opme/motor-driver/(list of files, drawings)

Other design files:
opm-inline-mcu/source/opm-inline.dsn
