opme/motor-driver/opm-inline/source/opm-inline.kicad_pcb

## KiCad design opm-inline/source/opm-inline.kicad_pcb (2022-01-27)

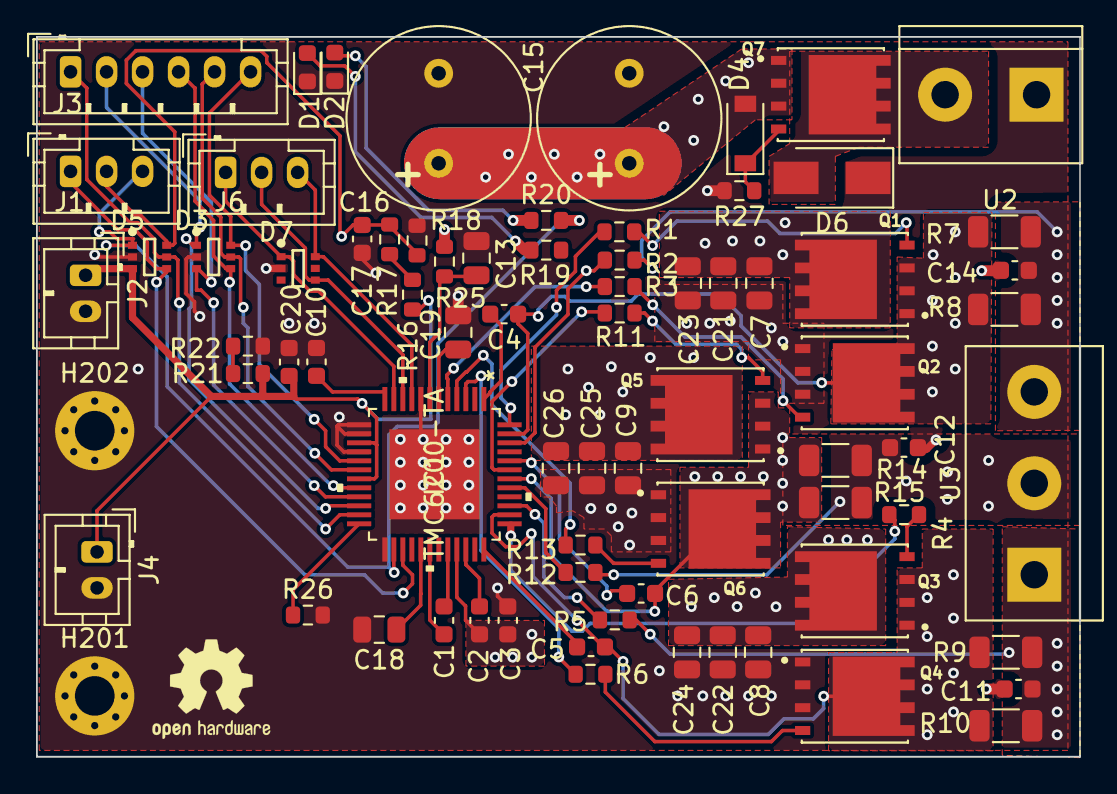
[picture p2: board opm-inline.kicad_pcb from above]

Board: 4 copper layers, 58.0 x 40.0 mm, 76 parts (0 on the bottom side), 53 nets.

Parts:
C1: 22nF/100V; C_0603_1608Metric
C2, C3: 100nF/100V; C_0603_1608Metric
C4: 4.7uF/16V; C_0603_1608Metric
C5, C6: 4.7UF/16V; C_0603_1608Metric
C7, C8, C9, C21, C22, C23, C24, C25, C26: 1uF/100V; C_0805_2012Metric
C10, C17, C20: 100nF/50V; C_0603_1608Metric
C11, C12, C14: 1nF/100V; C_0603_1608Metric
C13, C19: 2.2uF/50V; C_0805_2012Metric
C15, C16: 330uF/63V; C_Radial_D10.0mm_H20.0mm_P5.00mm
C18: 100nF/100V; C_0805_2012Metric
D1: Blue LED; LED_0603_1608Metric
D2: Red LED; LED_0603_1608Metric
D3, D5, D7: NUP4114UCW1T2G
D4: 10V; D_SOD-123
D6: TVS DIODE; D_SMA
H201, H202: MountingHole; MountingHole_2.2mm_M2_Pad_Via
HS1: Heatsink; OSHW-Logo2_7.3x6mm_SilkScreen
IC1: TMC6200-TA
J1: Info; JST_PH_B3B-PH-K_1x03_P2.00mm_Vertical
J2: VCC_IO; JST_PH_B2B-PH-K_1x02_P2.00mm_Vertical
J3: PWMx6; JST_PH_B6B-PH-K_1x06_P2.00mm_Vertical
J4: Fan; JST_PH_B2B-PH-K_1x02_P2.00mm_Vertical
J6: Current Sensing; JST_PH_B3B-PH-K_1x03_P2.00mm_Vertical
Q1, Q2, Q3, Q4, Q5, Q6: HYG025N06LS1C2; PDFN-8
Q7: WSD90P06DN56; PDFN-8
R1, R3, R4, R6, R11, R13: 2R2/1%; R_0603_1608Metric
R2, R5, R12: 10R/1%; R_0603_1608Metric
R7, R8, R9, R10, R14, R15: 0R005/1%/1W; R_1206_3216Metric
R16: 10000R/1%; R_0603_1608Metric
R17, R18: 4700R/1%; R_0603_1608Metric
R19: 2KR/1%; R_0603_1608Metric
R20: 200R/1%; R_0603_1608Metric
R21: 1000R/1%; R_0603_1608Metric
R22, R26: 0R; R_0603_1608Metric
R25: 0Ω; R_0603_1608Metric
R27: 100KR; R_0603_1608Metric
U2: TerminalBlock_2_P5.08mm; TerminalBlock_bornier-2_P5.08mm
U3: TerminalBlock_3_P5.08mm; TerminalBlock_bornier-3_P5.08mm

Connections:
/5Vout: C13.1, IC1.7 (5VOUT), R25.1
/12Vout: C19.1, IC1.6 (12VOUT)
/+VCC_IO: C20.1, D5.3 (K), IC1.15 (SDI/AMPLx10), IC1.19 (VCC_IO), J2.1, J4.1, R16.1, R21.1
/+VM: C2.1, C3.1, C7.1, C8.1, C9.1, C15.1, C16.1, C21.1, C22.1, C23.1, C24.1, C25.1, C26.1, D4.2 (K), IC1.33 (VS), Q1.5 (D), Q1.6 (D), Q1.7 (D), Q1.8 (D), Q3.5 (D), Q3.6 (D), Q3.7 (D), Q3.8 (D), Q5.5 (D), Q5.6 (D), Q5.7 (D), Q5.8 (D), Q7.1 (S), Q7.2 (S), Q7.3 (S), R25.2
/ADC_I_u: D7.6 (K), IC1.9 (CURU), J6.3
/ADC_I_v: D7.4 (K), IC1.10 (CURV), J6.2
/ADC_I_w: D7.1 (K), IC1.11 (CURW), J6.1
/Connectors/VOFS: R21.2, R22.1
/DRV_EN: D5.4 (K), IC1.27 (DRV_EN), J1.1
/FAULT: D5.1 (K), IC1.26 (FAULT), J1.3, R20.2
/Motor Driver/VOFS: C10.1, IC1.12 (VOFS/TEST)
/TEMP_PCB: C17.1, D5.6 (K), J1.2, R17.2, R18.1
/U: C14.1, R2.1, R7.1, R8.1, U3.3
/UH: D3.6 (K), IC1.17 (UH), J3.6
/UL: D3.5 (K), IC1.18 (UL), J3.5
/V: C12.1, R12.1, R14.1, R15.1, U3.2
/VH: D3.4 (K), IC1.20 (VH), J3.4
/VL: D3.3 (K), IC1.21 (VL), J3.3
/VSA: C18.1, IC1.29 (VSA)
/W: C11.1, R5.1, R9.1, R10.1, U3.1
/WH: D3.1 (K), IC1.22 (WH), J3.2
/WL: D5.5 (K), IC1.23 (WL), J3.1
GND: C3.2, C7.2, C8.2, C9.2, C10.2, C11.2, C12.2, C13.2, C14.2, C15.2, C16.2, C17.2, C18.2, C19.2, C20.2, C21.2, C22.2, C23.2, C24.2, C25.2, C26.2, D1.1 (K), D2.1 (K), D3.2 (A), D5.2 (A), D6.1 (A), D7.2 (A), H201.1, H202.1, IC1.8 (GNDA), IC1.13 (CS/IDRV0), IC1.14 (SCK/IDRV1), IC1.16 (SDO_SINGLE), IC1.25 (SPE), IC1.EPAD, J2.2, J4.2, Q2.1 (S), Q2.2 (S), Q2.3 (S), Q4.1 (S), Q4.2 (S), Q4.3 (S), Q6.1 (S), Q6.2 (S), Q6.3 (S), R18.2, R22.2, R26.2, R27.2, U2.1
unnamed: C1.1, IC1.30 (CPO)
unnamed: C1.2, IC1.32 (CPI)
unnamed: C2.2, IC1.34 (VCP)
unnamed: C4.1, IC1.47 (U), Q1.1 (S), Q1.2 (S), Q1.3 (S), Q2.5 (D), Q2.6 (D), Q2.7 (D), Q2.8 (D), R7.2, R8.2
unnamed: C4.2, IC1.1 (CU)
unnamed: C5.1, IC1.36 (CW)
unnamed: C5.2, IC1.38 (W), Q3.1 (S), Q3.2 (S), Q3.3 (S), Q4.5 (D), Q4.6 (D), Q4.7 (D), Q4.8 (D), R9.2, R10.2
unnamed: C6.1, IC1.42 (V), Q5.1 (S), Q5.2 (S), Q5.3 (S), Q6.5 (D), Q6.6 (D), Q6.7 (D), Q6.8 (D), R14.2, R15.2
unnamed: C6.2, IC1.44 (CV)
unnamed: D1.2 (A), R19.1
unnamed: D2.2 (A), R20.1
unnamed: D4.1 (A), Q7.4 (G), R27.1
unnamed: D6.2 (K), Q7.5 (D), Q7.6 (D), Q7.7 (D), Q7.8 (D), U2.2
unnamed: IC1.3 (LSW), R6.2
unnamed: IC1.4 (LSV), R13.2
unnamed: IC1.5 (LSU), R3.2
unnamed: IC1.24 (CLK), R26.1
unnamed: IC1.37 (HSW), R4.2
unnamed: IC1.39 (WSENSE), R5.2
unnamed: IC1.41 (VSENSE), R12.2
unnamed: IC1.43 (HSV), R11.2
unnamed: IC1.46 (USENSE), R2.2
unnamed: IC1.48 (HSU), R1.2
unnamed: Q1.4 (G), R1.1
unnamed: Q2.4 (G), R3.1
unnamed: Q3.4 (G), R4.1
unnamed: Q4.4 (G), R6.1
unnamed: Q5.4 (G), R11.1
unnamed: Q6.4 (G), R13.1
unnamed: R16.2, R17.1
