opme/motor-driver/tmc6100-eval/TMC6100-EVAL v1.2.kicad_pcb

## KiCad design tmc6100-eval/TMC6100-EVAL v1.2.kicad_pcb (2022-01-21)

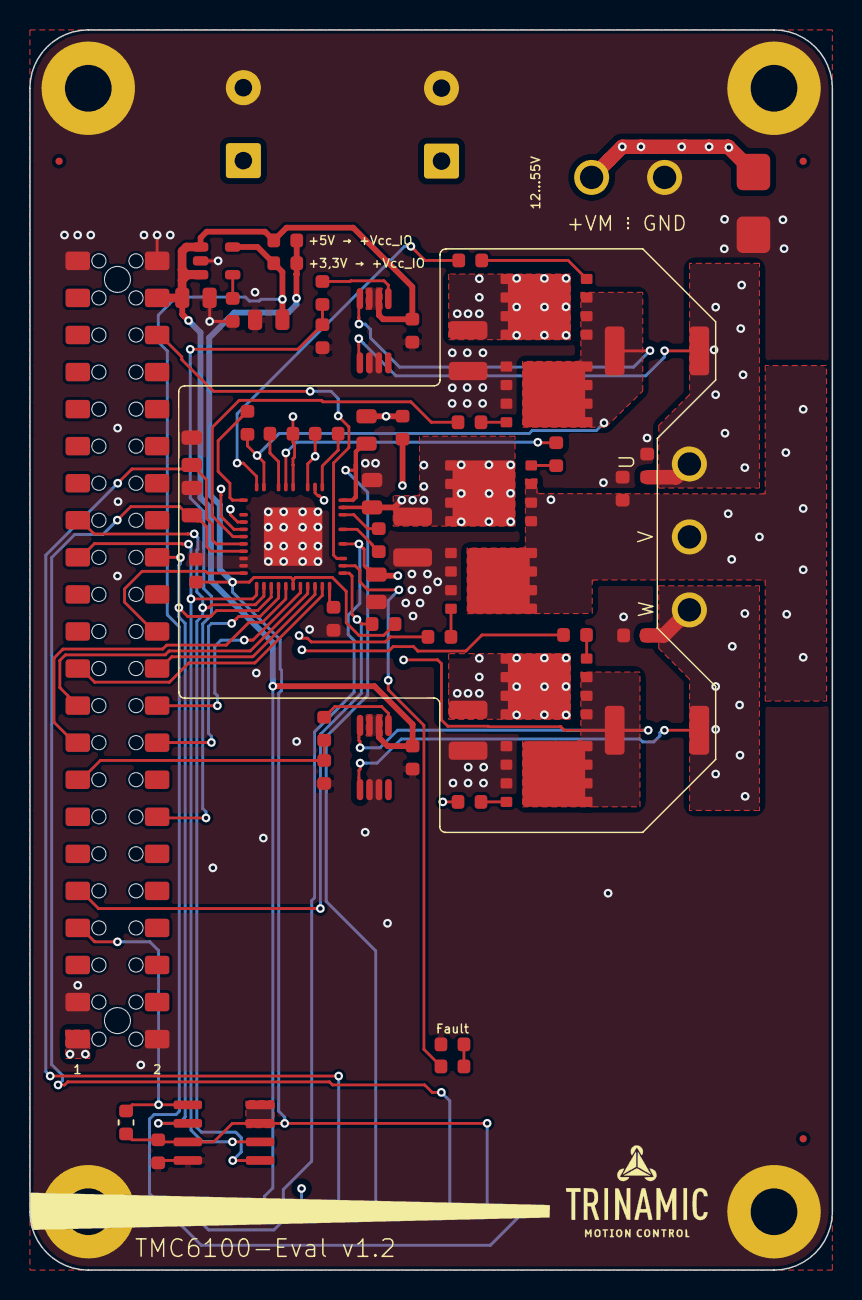
[picture p3: board TMC6100-EVAL v1.2.kicad_pcb from above]

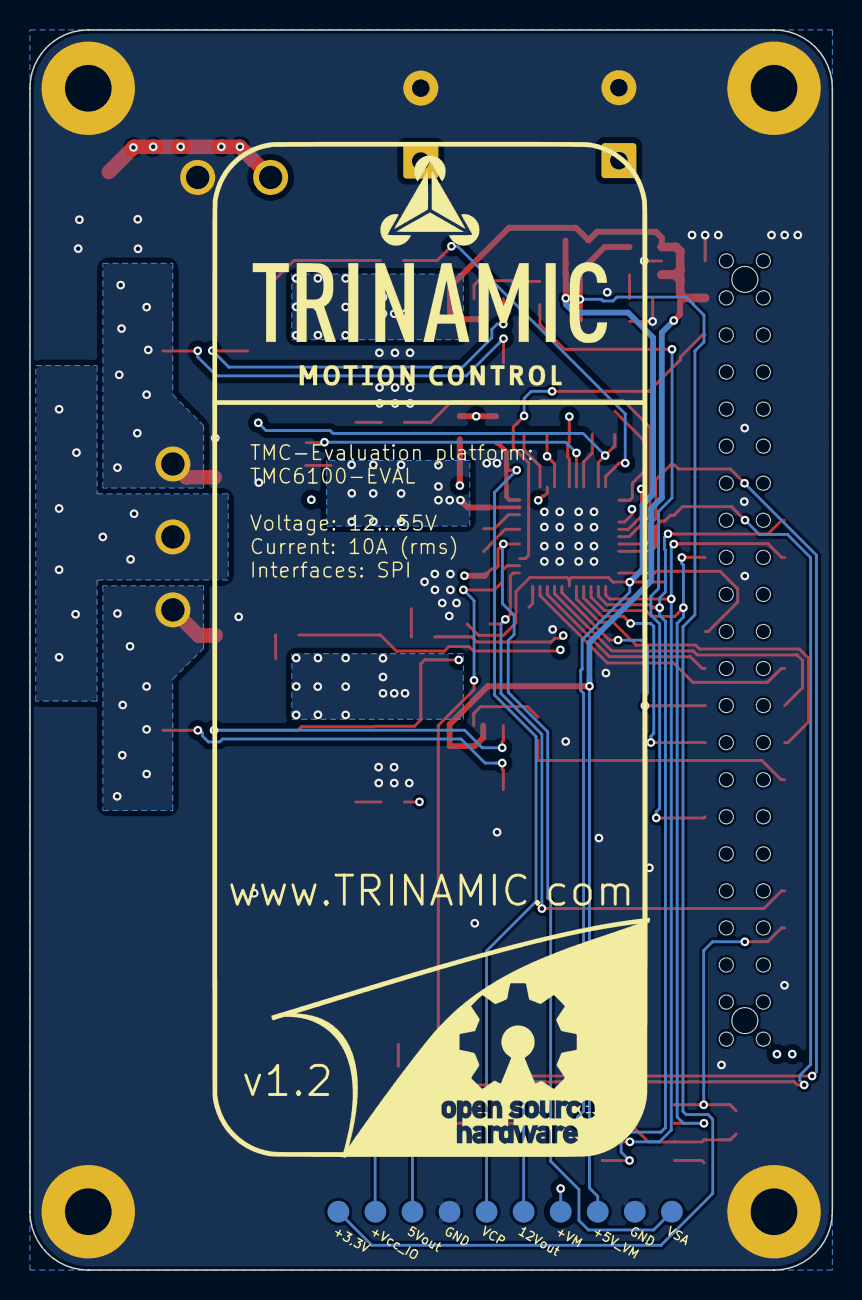
[picture p4: board TMC6100-EVAL v1.2.kicad_pcb from below]

Board: 4 copper layers, 55.0 x 85.0 mm, 76 parts (10 on the bottom side), 52 nets.

Parts:
C201, C202: 220μF/100V; CP_Radial_D12.5mm_P5.00mm
C203, C204, C205: 1nF/100V; C_0603_1608Metric
C301, C316: 100nF/16V; C_0603_1608Metric
C302, C317: 2,2nF/16V; C_0603_1608Metric
C303, C310, C318: 470nF/16V; C_0603_1608Metric
C304, C314, C319: 2,2μF/100V; C_1210_3225Metric
C305, C307, C311: 100nF/100V; C_0805_2012Metric
C306: 22nF/100V; C_0603_1608Metric
C312, C313: 2,2μF/50V; C_0805_2012Metric
C315, C404: 100nF/50V; C_0603_1608Metric
C401, C403: 4,7μF/16V; C_0805_2012Metric
C402: 10nF/16V; C_0603_1608Metric
D401: HSMC-C190; LED_0603_1608Metric
D402: SMBJ58A; D_SMB
H201, H202, H203, H204: MountingHole; MountingHole_3.2mm_M3_Pad
IC301: TMC6100-LA; QFN-44-1EP_7x7mm_P0.5mm_EP4x4mm
J201: W+P_46-3492-44-3-00-10-PPTR; Samtec_HLE-144-02-xxx-DV-BE-A_2x22_P2.54mm_Horizontal
Q301, Q302, Q303, Q304, Q305, Q306: BSC026N08NS5; TDSON-8-1
R203: 10kΩ/1%; R_0603_1608Metric
R301: 10kΩ/1%/0603; R_0603_1608Metric
R303, R317: 1kΩ/1%; R_0603_1608Metric
R304, R306, R310, R313, R318, R320: 2,2Ω/1%; R_0603_1608Metric
R305, R319: 3mΩ/1%/3W; R_2512_6332Metric
R311, R314, R401, R402: 0Ω; R_0603_1608Metric
R403: 150Ω/1%; R_0603_1608Metric
TP201, TP202, TP203, TP204, TP205, TP206, TP207, TP208, TP209, TP210: TestPoint; TestPoint_Pad_D1.5mm
U201: Metz_31330102
U203: Metz_31330103
U301, U303: AD8418; MSOP-8_3x3mm_P0.65mm
U401: LP2985-3.3; SOT-23-5
U402: AT25128B-SSHL-T8S1-L; SOIC-8_3.9x4.9mm_P1.27mm
fid201, fid202, fid203: fiducial; Fiducial_0.5mm_Dia_1mm_Outer

Connections:
/5Vout: C313.1, IC301.7, TP208.1
/12Vout: C312.1, IC301.6, TP205.1
/+3,3V: C403.1, R402.2, TP210.1, U401.5
/+5V_VM: C301.1, C316.1, C401.1, J201.42, R401.2, TP203.1, U301.6, U301.7, U303.6, U303.7, U401.1, U401.3
/+VM: C201.1, C202.1, C304.1, C305.2, C307.2, C314.1, C319.1, D402.1, IC301.28, J201.1, Q301.5, Q303.5, Q305.5, R311.2, TP204.1, U201.2
/+Vcc_IO: C315.1, C404.2, IC301.16, R203.2, R301.1, R401.1, R402.1, TP209.1, U402.3, U402.7, U402.8
/ADC_I_u: C302.1, J201.14, R303.1
/ADC_I_w: C317.1, J201.15, R317.1
/DRV_EN: IC301.24, J201.40
/Fault: IC301.23, R403.2
/SPE: IC301.22, J201.9, R203.1
/SPI2_MISO: IC301.13, J201.28, U402.2
/SPI2_MOSI: IC301.12, J201.29, U402.5
/SPI2_SCK: IC301.11, J201.27, U402.6
/U: C203.1, R305.1, U203.3, U301.1
/UH: IC301.14, J201.18
/UL: IC301.15, J201.17
/V: C204.1, C310.1, IC301.33, Q303.1, Q303.2, Q303.3, Q304.5, U203.2
/VCP: C307.1, IC301.29, TP206.1
/VH: IC301.17, J201.20
/VL: IC301.18, J201.19
/VSA: C311.1, IC301.25, R311.1, TP201.1
/W: C205.1, R319.1, U203.1, U303.1
/WH: IC301.19, J201.22
/WL: IC301.20, J201.21
/~CS_DRIVER: IC301.10, J201.24
/~CS_EEPROM: J201.7, R301.2, U402.1
GND: C201.2, C202.2, C203.2, C204.2, C205.2, C301.2, C302.2, C304.2, C305.1, C311.2, C312.2, C313.2, C314.2, C315.2, C316.2, C317.2, C319.2, C401.2, C402.2, C403.2, C404.1, D401.1, D402.2, H201.1, H202.1, H203.1, H204.1, IC301.8, IC301.9, IC301.PAD, J201.2, J201.3, J201.43, J201.44, Q302.1, Q302.2, Q302.3, Q304.1, Q304.2, Q304.3, Q306.1, Q306.2, Q306.3, R314.2, TP202.1, TP207.1, U201.1, U301.2, U301.3, U303.2, U303.3, U401.2, U402.4
unnamed: C303.1, IC301.36, Q301.1, Q301.2, Q301.3, Q302.5, R305.2, U301.8
unnamed: C303.2, IC301.1
unnamed: C306.1, IC301.27
unnamed: C306.2, IC301.26
unnamed: C310.2, IC301.35
unnamed: C318.1, IC301.32, Q305.1, Q305.2, Q305.3, Q306.5, R319.2, U303.8
unnamed: C318.2, IC301.30
unnamed: C402.1, U401.4
unnamed: D401.2, R403.1
unnamed: IC301.3, R320.2
unnamed: IC301.4, R313.2
unnamed: IC301.5, R306.2
unnamed: IC301.21, R314.1
unnamed: IC301.31, R318.2
unnamed: IC301.34, R310.2
unnamed: IC301.37, R304.2
unnamed: Q301.4, R304.1
unnamed: Q302.4, R306.1
unnamed: Q303.4, R310.1
unnamed: Q304.4, R313.1
unnamed: Q305.4, R318.1
unnamed: Q306.4, R320.1
unnamed: R303.2, U301.5
unnamed: R317.2, U303.5
