opme/motor-driver/opm-lowside/source/opm-lowside.kicad_pcb

## KiCad design opm-lowside/source/opm-lowside.kicad_pcb (2022-01-21)

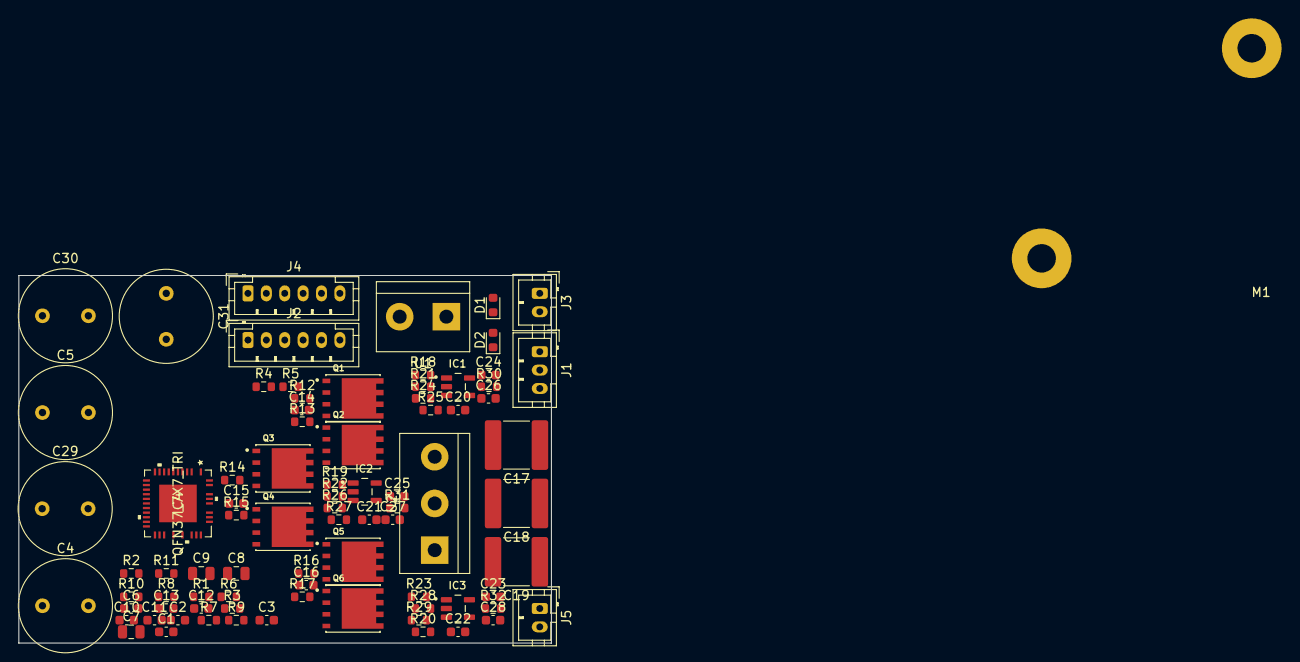
[picture p5: board opm-lowside.kicad_pcb from above]

Board: 2 copper layers, 58.0 x 40.0 mm, 84 parts (0 on the bottom side), 65 nets, no tracks yet.

Parts:
C1, C2, C3: 1nF/100V; C_0603_1608Metric
C4, C5, C29, C30, C31: 330uF/63V; C_Radial_D10.0mm_H20.0mm_P5.00mm
C6, C10: 100nF/50V; C_0603_1608Metric
C7: 100nF/100V; C_0805_2012Metric
C8, C9: 2,2uF/50V; C_0805_2012Metric
C11: 22nF/100V; C_0603_1608Metric
C12, C13: 100nF/100V; C_0603_1608Metric
C14, C15, C16: 470nF/16V; C_0603_1608Metric
C17, C18, C19: 10uF/100V; C_2220_5650Metric
C20, C21, C22: 3300pF; C_0603_1608Metric
C23, C24, C25: 100nF/10V; C_0603_1608Metric
C26, C27, C28: 1nF/16V; C_0603_1608Metric
D1, D2: 19-217/GHC-YR1S2/3T; LED_0603_1608Metric
HS1: Heatsink; Heatsink_30x30mm_2xFixation3mm
IC1, IC2, IC3: INA180A3IDBVR; SOT95P280X145-5N
IC4: QFN37_7X7_TRI; TMC6100-LA
J1: Current Sensing; JST_PH_B3B-PH-K_1x03_P2.00mm_Vertical
J2: SPI/Info; JST_PH_B6B-PH-K_1x06_P2.00mm_Vertical
J3: VCC_IO; JST_PH_B2B-PH-K_1x02_P2.00mm_Vertical
J4: PWMx6; JST_PH_B6B-PH-K_1x06_P2.00mm_Vertical
J5: Temperature; JST_PH_B2B-PH-K_1x02_P2.00mm_Vertical
M1: Fan; Fan_3010
Q1, Q2, Q3, Q4, Q5, Q6: HYG025N06LS1C2; PDFN-8
R1: 10000R/1%; R_0603_1608Metric
R2, R3, R9: 4700R/1%; R_0603_1608Metric
R4, R6: 1000R/1%; R_0603_1608Metric
R5: 150R/1%; R_0603_1608Metric
R7, R10, R11: 0R; R_0603_1608Metric
R8: 1500R/1%; R_0603_1608Metric
R12, R13, R14, R15, R16, R17: 2.2R/1%; R_0603_1608Metric
R18, R19, R20, R21, R22, R23: R001/1%; R_0603_1608Metric
R24, R25, R26, R27, R28, R29: 10R/1%; R_0603_1608Metric
R30, R31, R32: 100R/5%; R_0603_1608Metric
U1: TerminalBlock_2_P5.08mm; TerminalBlock_bornier-2_P5.08mm
U2: TerminalBlock_3_P5.08mm; TerminalBlock_bornier-3_P5.08mm

Connections:
+5V: C1.2, C2.2, C3.2, C4.2, C5.2, C6.2, C7.2, C8.2, C9.2, C10.2, C12.1, C17.2, C18.2, C19.2, C23.1, C24.1, C25.1, C26.2, C27.2, C28.2, C29.2, C30.2, C31.2, D1.1, D2.1, IC1.2, IC2.2, IC3.2, IC4.8, IC4.9, J3.2, J5.2, R3.2, R7.2, R9.2, R11.2, R18.2, R19.2, R21.2, R22.2, R25.2, R27.2, U1.1
/5Vout: C9.1, IC4.7
/12Vout: C8.1, IC4.6
/+VM: C4.1, C5.1, C12.2, C13.2, C17.1, C18.1, C19.1, C29.1, C30.1, C31.1, IC4.28, Q1.1, Q1.2, Q1.3, Q3.1, Q3.2, Q3.3, Q5.1, Q5.2, Q5.3, U1.2
/+Vcc_IO: C10.1, IC4.16
/Connectors/+VCC_IO: R6.1, R8.1
/Connectors/VOFS: R6.2, R7.1
/DRV_EN: IC4.24, J2.5
/SPE: IC4.22, R8.2, R9.1
/U: C3.1, U2.3
/UH: IC4.14, J4.6
/UL: IC4.15, J4.5
/V: C2.1, U2.2
/VCP: C13.1, IC4.29
/VH: IC4.17, J4.4
/VL: IC4.18, J4.3
/VSA: C7.1, IC4.25, R10.1
/W: C1.1, U2.1
/WH: IC4.19, J4.2
/WL: IC4.20, J4.1
/~CS_DRIVER: IC4.10, J2.1
unnamed: C6.1, J5.1, R2.2, R3.1
unnamed: C11.1, IC4.27
unnamed: C11.2, IC4.26
unnamed: C14.1, IC4.36, Q1.5, Q1.6, Q1.7, Q1.8, Q2.1, Q2.2, Q2.3
unnamed: C14.2, IC4.1
unnamed: C15.1, IC4.33, Q3.5, Q3.6, Q3.7, Q3.8, Q4.1, Q4.2, Q4.3
unnamed: C15.2, IC4.35
unnamed: C16.1, IC4.32, Q5.5, Q5.6, Q5.7, Q5.8, Q6.1, Q6.2, Q6.3
unnamed: C16.2, IC4.30
unnamed: C20.1, IC1.3, R24.1
unnamed: C20.2, IC1.4, R25.1
unnamed: C21.1, IC2.3, R26.1
unnamed: C21.2, IC2.4, R27.1
unnamed: C22.1, IC3.3, R28.1
unnamed: C22.2, IC3.4, R29.1
unnamed: C23.2, IC3.5
unnamed: C24.2, IC1.5
unnamed: C25.2, IC2.5
unnamed: D1.2, R4.1
unnamed: D2.2, R5.1
unnamed: IC1.1, R30.2
unnamed: IC2.1, R31.2
unnamed: IC3.1, R32.2
unnamed: IC4.3, R17.2
unnamed: IC4.4, R15.2
unnamed: IC4.5, R13.2
unnamed: IC4.21, R11.1
unnamed: IC4.31, R16.2
unnamed: IC4.34, R14.2
unnamed: IC4.37, R12.2
unnamed: Q1.4, R12.1
unnamed: Q2.4, R13.1
unnamed: Q2.5, Q2.6, Q2.7, Q2.8, R18.1, R21.1, R24.2
unnamed: Q3.4, R14.1
unnamed: Q4.4, R15.1
unnamed: Q4.5, Q4.6, Q4.7, Q4.8, R19.1, R22.1, R26.2
unnamed: Q5.4, R16.1
unnamed: Q6.4, R17.1
unnamed: Q6.5, Q6.6, Q6.7, Q6.8, R20.1, R23.1, R28.2
unnamed: R1.2, R2.1
unnamed: R20.2, R23.2, R29.2
U-IA-IDC: C26.1, R30.1
V-IA-IDC: C27.1, R31.1
W-IA-IDC: C28.1, R32.1
