opme/motor-driver/(commit log)

2021-12-13 remove unneeded
    [Cheap FOCer 2 60mm-B_Mask.gbr, Cheap FOCer 2 60mm-B_Paste.gbr, Cheap FOCer 2 60mm-B_SilkS.gbr, Cheap FOCer 2 60mm-Bottom_Signal.gbr, Cheap FOCer 2 60mm-Edge_Cuts.gbr, Cheap FOCer 2 60mm-F_Mask.gbr, Cheap FOCer 2 60mm-F_Paste.gbr, Cheap FOCer 2 60mm-F_SilkS.gbr]
2021-12-13 add libs
    [BLDC_4-2018-12-23-16-33-14.sch, BLDC_4-2018-12-23-16-59-10.sch, BLDC_4-2018-12-23-17-20-44.sch, BLDC_4-2018-12-23-17-25-32.sch, BLDC_4-2018-12-23-18-29-40.sch, CAN-2018-12-23-16-33-14.sch, CAN-2018-12-23-16-59-10.sch, CAN-2018-12-23-17-20-44.sch]
2021-12-13 change path
    [motor-driver.sch, motor-driver_1.sch, motor-driver_2.sch, motor-driver_3.sch, motor-driver_4.sch]
2021-12-13 add tmc libs
    [Power.sch, mosfets.sch]
2021-12-13 rename files
    [Cheap FOCer 2 60mm.kicad_pcb, Cheap FOCer 2 60mm.sch, opm-high.kicad_pcb, opm-high.sch]
2021-12-14 add high current inline
    [Connectors.sch, Connevtors.sch, Main setup.sch, Motor Driver.sch, Regulator and ID.sch, TMC6100-EVAL v1.2.kicad_pcb, TMC6100-EVAL v1.2.sch]
2021-12-15 update for current sense
    [Motor Driver.sch]
2021-12-16 add inline and cleanup
    [6200_11-1-2018.sch, 6200_11-1-2018_1.sch, 6200_11-1-2018_2.sch, 6200_11-1-2018_3.sch, 6200_11-1-2018_4.sch, BLDC_4.dsn, Board Connector and Pads.sch, CAN.sch]
2021-12-16 some work on inline
    [Motor Driver.sch, opm-inline.kicad_pcb, opm-inline.sch]
2021-12-16 add some values
    [Motor Driver.sch]
2021-12-16 more value updates
    [Motor Driver.sch, opm-inline.sch]
2021-12-16 update parts
    [Motor Driver.sch]
2021-12-17 add more lssc basic parts
    [Motor Driver.sch]
2021-12-17 update libs
    [Connevtors.sch, Motor Driver.sch, Regulator and ID.sch, opm-lowside.sch]
2021-12-17 update connectors
    [Connevtors.sch]
2021-12-17 add fiducials
    [Connevtors.sch, Regulator and ID.sch]
2021-12-17 add more parts
    [Regulator and ID.sch]
2021-12-19 remove regulator
    [Connevtors.sch, Motor Driver.sch, opm-inline.sch, opm-lowside.sch]
2021-12-19 add headers
    [Connevtors.sch]
2021-12-19 prepare for pcb
    [Connevtors.sch]
2021-12-20 fix connections
    [Connevtors.sch, Motor Driver.sch, opm-inline.sch]
2021-12-20 adc out headers
    [Connevtors.sch, Motor Driver.sch, opm-inline.sch]
2021-12-20 add pcb
    [Connevtors.sch, Motor Driver.sch, opm-inline.kicad_pcb, opm-inline.sch]
2021-12-20 add footprint
2021-12-20 update caps
    [Connevtors.sch, opm-inline.kicad_pcb]
2021-12-21 update resistors
    [Motor Driver.sch, opm-inline.kicad_pcb]
2021-12-21 more layout work
    [Motor Driver.sch, opm-inline.kicad_pcb]
2021-12-21 more placements
    [Connevtors.sch, opm-inline.kicad_pcb]
2021-12-21 some more layout
    [Motor Driver.sch, opm-inline.kicad_pcb]
2021-12-24 more layout
    [Connevtors.sch, Motor Driver.sch, opm-inline.csv, opm-inline.kicad_pcb, opm-inline.sch]
2021-12-25 update from latest
    [Connevtors.sch, Motor Driver.sch, opm-inline.kicad_pcb]
2021-12-25 fix some parts
    [Connevtors.sch, Motor Driver.sch]
2021-12-25 remove fiducials
    [opm-inline.kicad_pcb]
2021-12-26 fix rail
2021-12-26 fix naming
    [Connectors.sch, Connevtors.sch, Main setup.sch, MainSetup.sch, Motor Driver.sch, MotorDriver.sch, opm-inline.sch]
2021-12-26 fix spacing
    [opm-inline.kicad_pcb]
2021-12-26 adjust board size
    [opm-inline.kicad_pcb]
2021-12-26 update from netlist
    [opm-inline.kicad_pcb]
2021-12-26 add initial
    [Connectors.sch, Main setup.sch, MainSetup.sch, MotorDriver.sch, opm-lowside.sch]
2021-12-26 first config
    [Connectors.sch, MotorDriver.sch]
2021-12-26 add heatsink
    [Connectors.sch, opm-lowside.kicad_pcb]
2021-12-27 add step
    [opm-lowside.kicad_pcb]
2021-12-27 add fan
    [Connectors.sch, opm-lowside.kicad_pcb]
2021-12-27 add manf num
    [MotorDriver.sch]
2021-12-27 change spacing
    [opm-lowside.kicad_pcb]
2021-12-28 increase caps
    [MotorDriver.sch, opm-inline.kicad_pcb, opm-lowside.kicad_pcb]
2021-12-28 update position
    [Connectors.sch, opm-inline.kicad_pcb, opm-lowside.kicad_pcb]
2021-12-29 try routing
    [Connectors.sch, opm-inline.kicad_pcb, opm-lowside.kicad_pcb]
2021-12-31 more routing
    [Connectors.sch, MotorDriver.sch, opm-inline.kicad_pcb]
2022-01-02 update bom
2022-01-02 add pic
    [Connectors.sch, MotorDriver.sch, opm-inline.dsn, opm-inline.kicad_pcb]
2022-01-02 add image
    [bom.csv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]
2022-01-02 update connections
    [Connectors.sch, MotorDriver.sch, opm-inline.dsn, opm-inline.kicad_pcb]
2022-01-03 use pins
    [Connectors.sch, MotorDriver.sch, opm-inline.dsn, opm-inline.kicad_pcb]
2022-01-09 route tracks
    [opm-inline.kicad_pcb]
2022-01-16 sample fab
    [bom.csv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]
2022-01-16 update fab
    [opm-inline-CmtUser.gbr, opm-inline-CuBottom.gbl, opm-inline-CuTop.gtl, opm-inline-EdgeCuts.gm1, opm-inline-MaskBottom.gbs, opm-inline-MaskTop.gts, opm-inline-PasteBottom.gbp, opm-inline-PasteTop.gtp]
2022-01-16 fix current sense resistor
    [MotorDriver.sch]
2022-01-16 align refs
    [Connectors.sch, opm-inline.kicad_pcb]
2022-01-17 update back side copper pours
    [opm-inline.kicad_pcb]
2022-01-18 fix vias
    [opm-inline.kicad_pcb]
2022-01-19 fix missing track
    [opm-inline.kicad_pcb]
2022-01-19 tie spe low for standalone
    [Connectors.sch, MotorDriver.sch, opm-inline.kicad_pcb]
2022-01-21 upgrade to kicad6
    [TMC6100-EVAL v1.2.kicad_pcb, opm-inline.kicad_pcb, opm-lowside.kicad_pcb]
2022-01-21 update design rules
    [opm-inline.kicad_pcb]
2022-01-22 update 3d models
    [opm-inline.kicad_pcb]
2022-01-22 cleanup tracks
    [opm-inline.kicad_pcb]
2022-01-24 add version with mcu
    [Connectors.sch, MainSetup.sch, MotorDriver.sch, Regulator and ID.sch, bom.csv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]
2022-01-24 add mcu
    [Connectors.kicad_sch, MotorDriver.kicad_sch, mcu.kicad_sch, opm-inline.kicad_sch]
2022-01-24 update mcu
    [Connectors.kicad_sch, MotorDriver.kicad_sch, mcu.kicad_sch, opm-inline.kicad_pcb, opm-inline.kicad_sch]
2022-01-24 update for can
    [Regulator and ID.sch, can.kicad_sch]
2022-01-25 add can
    [can.kicad_sch, opm-inline.kicad_pcb, opm-inline.kicad_sch]
2022-01-27 add resistor info for led
2022-01-27 update led and resistor values
2022-01-27 updat resistor and led
    [can.kicad_sch, opm-inline.kicad_sch]
2022-01-27 update led
    [opm-inline.kicad_pcb]
2022-01-27 update cap
    [Connectors.kicad_sch, MotorDriver.kicad_sch, opm-inline.kicad_sch]
2022-01-27 remove files
    [Connectors.sch, MotorDriver.sch]
2022-01-27 fix red led
    [Connectors.kicad_sch]
